Smartlinuxcoder/firepi/pcb/bom.csv

No. | Quantity | Comment | Designator | Footprint | Value | Manufacturer Part | Manufacturer | Supplier Part | Supplier | LCSC Price | Name
1 | 2 | 15pF | C17,C18 | C0402 | 15pF | 0402CG150J500NT | FH(风华) | C1548 | LCSC |  | 15pF
2 | 5 | 4.7uF | C22,C23,C24,C40,C55 | C0402 | 4.7uF | CL05A475MP5NRNC | SAMSUNG(三星) | C23733 | LCSC |  | 4.7uF
3 | 21 | 100nF | C25,C27,C29,C30,C31,C32,C33,C34,C35,C41,C42,C43,C44,C45,C46,C47,C48,C49,C69,C73,C74 | C0402 | 100nF | CL05B104KO5NNNC | SAMSUNG(三星) | C1525 | LCSC |  | 100nF
4 | 6 | 4.7uF | C60,C61,C64,C65,C66,C67 | C0603 | 4.7uF | CL10A475KO8NNNC | SAMSUNG(三星) | C19666 | LCSC |  | 4.7uF
5 | 1 | 22uF | C68 | C0805 | 22uF | CL21A226MAQNNNE | SAMSUNG(三星) | C45783 | LCSC |  | 22uF
6 | 1 | 100uF | C70 | C1206 | 100uF | CL31A107MQHNNNE | SAMSUNG(三星) | C15008 | LCSC |  | 100uF
7 | 2 | 10uF | C71,C72 | C0805 | 10uF | CL21A106KAYNNNE | SAMSUNG(三星) | C15850 | LCSC |  | 10uF
8 | 1 | TF-02A | CARD1 | TF-SMD_TF-02A |  | TF-02A | 韩国韩荣 | C105419 | LCSC |  | TF-02A
9 | 2 | TPD2EUSB30ADRTR | D1,D2 | SOT-9X3-3_L1.0-W0.8-P0.35-LS1.0-BR |  | TPD2EUSB30ADRTR | TI(德州仪器) | C94934 | LCSC |  | TPD2EUSB30ADRTR
10 | 1 | 2.54mm 2*20P直排针 | H1 | HDR-TH_40P-P2.54-V-M-R2-C20-S2.54 |  | 2.54mm 2*20P直排针 | BOOMELE(博穆精密) | C50980 | LCSC |  | 2.54mm 2*20P直排针
11 | 1 | 2.54-1*5 | H2 | HDR-TH_5P-P2.54-V-M |  | 2.54-1*5 | ZHOURI(洲日) | C5156614 | LCSC |  | 2.54-1*5
12 | 1 | AOTA-B201610S3R3-101-T | L1 | IND-SMD_L2.0-W1.6_AOTA-B201610S3R3-101-T |  | AOTA-B201610S3R3-101-T | ABRACON | C42411119 | LCSC |  | AOTA-B201610S3R3-101-T
13 | 1 | BLM21PG121SN1D | L2 | L0805 |  | BLM21PG121SN1D | muRata(村田) | C79382 | LCSC |  | BLM21PG121SN1D
14 | 4 | SK6805-EC14 | LED1,LED2,LED3,LED4 | LED-SMD_4P-L1.4-W1.4-TL |  | SK6805-EC14 | 欧思科光电 | C2909055 | LCSC |  | SK6805-EC14
15 | 1 | KT-0805Y | LED5 | LED0805-R-RD |  | KT-0805Y | KENTO | C2296 | LCSC |  | KT-0805Y
16 | 1 | KT-0805G | LED6 | LED0805-R-RD |  | KT-0805G | KENTO | C2297 | LCSC |  | KT-0805G
17 | 3 | 1kΩ | R6,R12,R24 | R0402 | 1kΩ | 0402WGF1001TCE | UNI-ROYAL(厚声) | C11702 | LCSC |  | 1kΩ
18 | 4 | 5.1kΩ | R7,R8,R22,R23 | R0402 | 5.1kΩ | 0402WGF5101TCE | UNI-ROYAL(厚声) | C25905 | LCSC |  | 5.1kΩ
19 | 1 | 33Ω | R9 | R0805 | 33Ω | 0805W8J0330T5E | UNI-ROYAL(厚声) | C25307 | LCSC |  | 33Ω
20 | 2 | 27Ω | R10,R11 | R0402 | 27Ω | 0402WGF270JTCE | UNI-ROYAL(厚声) | C25100 | LCSC |  | 27Ω
21 | 1 | 47kΩ | R21 | R0603 | 47kΩ | 0603WAF4702T5E | UNI-ROYAL(厚声) | C25819 | LCSC |  | 47kΩ
22 | 4 | 10kΩ | R25,R26,R27,R28 | R0402 | 10kΩ | 0402WGF1002TCE | UNI-ROYAL(厚声) | C25744 | LCSC |  | 10kΩ
23 | 2 | 220Ω | R29,R30 | R0402 | 220Ω | 0402WGF2200TCE | UNI-ROYAL(厚声) | C25091 | LCSC |  | 220Ω
24 | 1 | 10kΩ | R31 | R0805 | 10kΩ | 0805W8F1002T5E | UNI-ROYAL(厚声) | C17414 | LCSC |  | 10kΩ
25 | 4 | TS-1088-AR02016 | SW1,SW2,SW3,SW4 | SW-SMD_L3.9-W3.0-P4.45 |  | TS-1088-AR02016 | XUNPU(讯普) | C720477 | LCSC |  | TS-1088-AR02016
26 | 1 | ICE40UP5K-SG48I | U1 | QFN-48_L7.0-W7.0-P0.50-TL-EP5.4-1 |  | ICE40UP5K-SG48I | LATTICE(莱迪思) | C2678152 | LCSC |  | ICE40UP5K-SG48I
27 | 1 | W25Q16JVSNIQ | U3 | SOP-8_L4.9-W3.9-P1.27-LS6.0-BL |  | W25Q16JVSNIQ | Winbond(华邦) | C2456211 | LCSC |  | W25Q16JVSNIQ
28 | 1 | MCP1700T-1202E/TT | U6 | SOT-23-3_L2.9-W1.3-P1.90-LS2.4-BR |  | MCP1700T-1202E/TT | MICROCHIP(美国微芯) | C144202 | LCSC |  | MCP1700T-1202E/TT
29 | 1 | RP2350A | U7 | QFN-60_L7.0-W7.0-P0.40-TL-EP3.4 |  | RP2350A | Raspberry Pi(树莓派) | C42411118 | LCSC |  | RP2350A
30 | 1 | ABM8-272-T3 | U8 | CRYSTAL-SMD_4P-L3.2-W2.5-BL |  | ABM8-272-T3 | ABRACON | C20625731 | LCSC |  | ABM8-272-T3
31 | 1 | W25Q128JVSIQ | U9 | SOIC-8_L5.3-W5.3-P1.27-LS8.0-BL |  | W25Q128JVSIQ | Winbond(华邦) | C113767 | LCSC |  | W25Q128JVSIQ
32 | 1 | NCP1117LPST33T3G | U10 | SOT-223_L6.5-W3.5-P2.30-LS7.0-BR |  | NCP1117LPST33T3G | onsemi(安森美) | C146799 | LCSC |  | NCP1117LPST33T3G
33 | 2 | USB-TYPE-C-017 | U11,U14 | USB-TYPE-C-SMD_C9900008089 |  | USB-TYPE-C-017 | DEALON(德艺隆) | C2927037 | LCSC |  | USB-TYPE-C-017
34 | 1 | 50MHz | X1 | OSC-SMD_4P-L5.0-W3.2-BL_OVETDLJTNF | 50MHz | OVETDLJTNF-50MHZ | TAITIEN(泰艺电子) | C117892 | LCSC |  | 50MHz
