Smartlinuxcoder/firepi/pcb/schematic.pdf

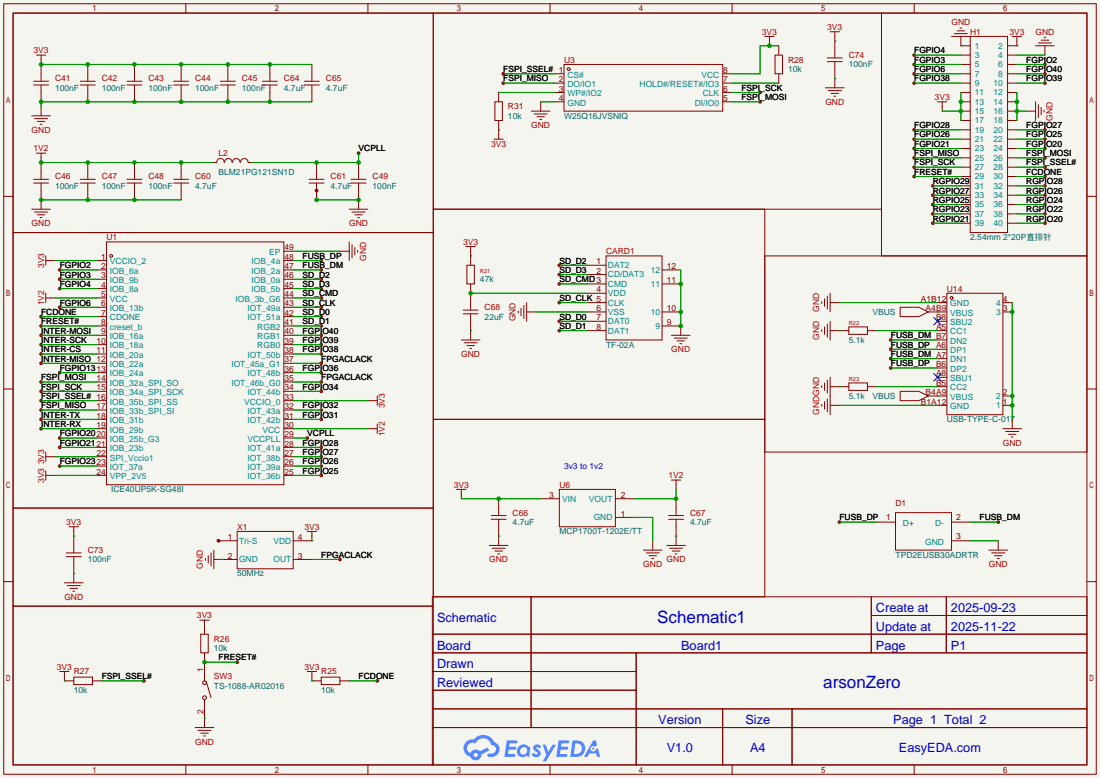
[picture p2: page 1]

GND GND

Schematic | Schematic1 | Create at | 2025-09-23

Update at | 2025-11-22

Board | Board1 | Page | P1
Drawn | | arsonZero
Reviewed

Version | Size | Page 1 Total 2
V1.0 | A4 | EasyEDA.com

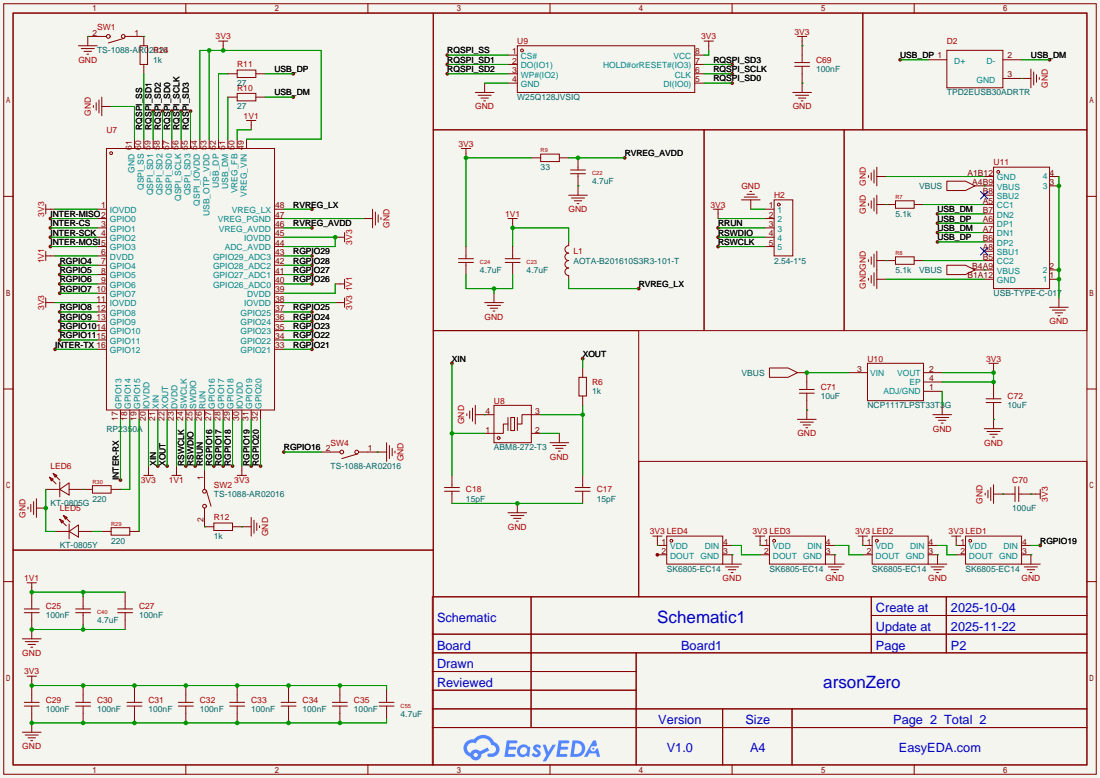
[picture p3: page 2]

GPIO21 33 GPIO22 34 GPIO23 35 GPIO24 36 GPIO25 37 IOVDD 38 DVDD 39 GPIO26_ADC0 40 GPIO27_ADC1 41 GPIO28_ADC2 42 GPIO29_ADC3 43 ADC_AVDD 44 IOVDD 45 VREG_AVDD 46 VREG_PGND 47 VREG_LX 48 VREG_VIN ⁴⁹ VREG_FB ⁵⁰ USB_DM ⁵¹ USB_DP ⁵² USB_OTP_VDD ⁵³ QSPI_IOVDD ⁵⁴ QSPI_SD³ ⁵⁵ QSPI_SCLK ⁵⁶ QSPI_SD⁰ ⁵⁷ QSPI_SD² ⁵⁸ QSPI_SD¹ ⁵⁹ QSPI_SS ⁶⁰

GND GND

Schematic | Schematic1 | Create at | 2025-10-04

Update at | 2025-11-22

Board | Board1 | Page | P2
Drawn | | arsonZero
Reviewed

Version | Size | Page 2 Total 2
V1.0 | A4 | EasyEDA.com
